cslammy/DLFO2/README.MD

Digital LFO using AVR328 MCU and embedded C.  Please see this blog post for more information:
http://audiodiwhy.blogspot.com/2021/10/dirty-digital-lfo-done.html
