cslammy/DLFO2/input output buffers DLFO.brd

## EAGLE design input output buffers DLFO.brd (2021-10-31)

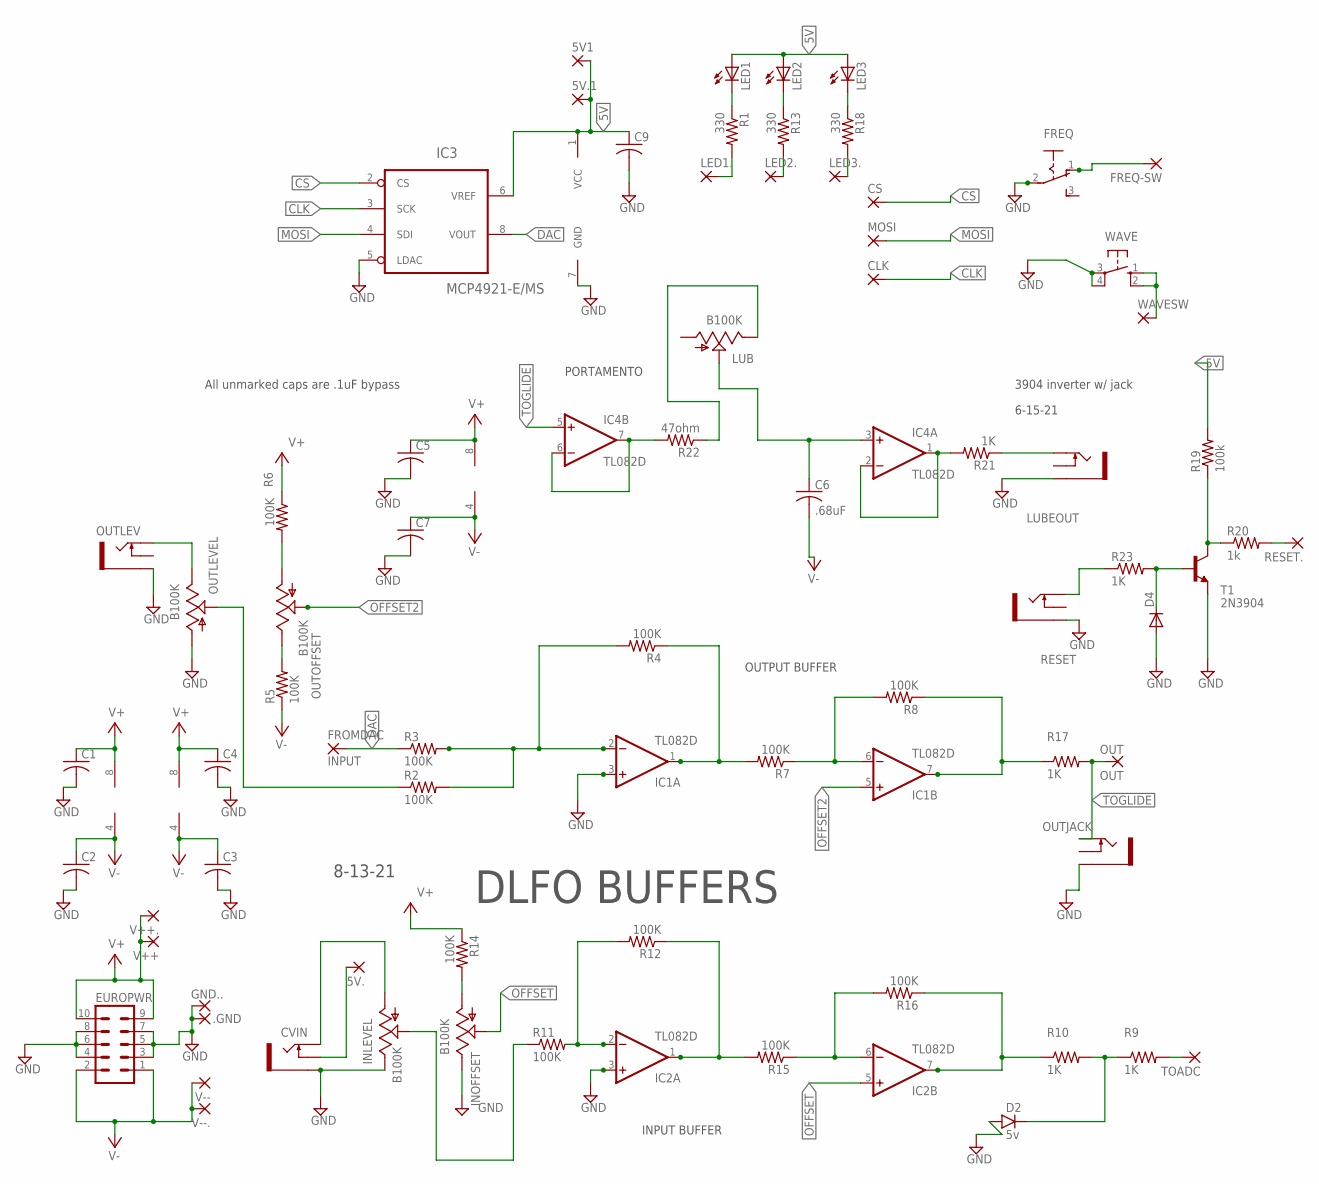
[picture p1: schematic input output buffers DLFO.sch]

Parts:
5V1, 5V.1: WIREPAD2,54/1,0; 2,54/1,0
5V., .GND: 3,17/1,3
C1, C2, C3, C4, C5, C7, C9: C-USC0603; C0603
C6: .68uF; C050-024X044
CLK: WIREPAD2,54/1,1; 2,54/1,1
CS: WIREPAD2,54/1,0; 2,54/1,0
CVIN: THONKICONNNEW; WQP-PJ301M-12_JACK
D2: 5v; DO41-2
D4: 1N4148DO35-10; DO35-10
EUROPWR: EURO_POWER_HEADERREGULAR; EURO_POWER_HEADER
FREQ: M251
FREQ-SW: WIREPAD2,54/0,9; 2,54/0,9
FROMDAC: INPUT; 3,17/1,3
GND..: 3,17/1,3
IC1, IC2, IC4: TL082D; SO08
IC3: MCP4921-E/MS; MSOP-8
INLEVEL: B100K; 9MM_SNAP-IN_POT
INOFFSET: B100K; 9MM_SNAP-IN_POT
LED1, LED2, LED3: LED3MM
LED1., LED2.: WIREPAD2,54/1,0; 2,54/1,0
LED3.: WIREPAD2,54/1,1; 2,54/1,1
LUB: B100K; 9MM_SNAP-IN_POT
LUBEOUT: THONKICONNNEW; WQP-PJ301M-12_JACK
MOSI: WIREPAD2,54/1,0; 2,54/1,0
OUT: OUT; 3,17/1,3
OUTJACK: THONKICONNNEW; WQP-PJ301M-12_JACK
OUTLEV: THONKICONNNEW; WQP-PJ301M-12_JACK
OUTLEVEL: B100K; 9MM_SNAP-IN_POT
OUTOFFSET: B100K; 9MM_SNAP-IN_POT
R1, R13, R18: 330; R0603
R2, R3, R4, R5, R6, R7, R8, R11, R12, R14, R15, R16: 100K; R0603
R9, R10, R17, R21, R23: 1K; R0603
R19: 100k; R0603
R20: 1k; R0603
R22: 47ohm; R0603
RESET: THONKICONNNEW; WQP-PJ301M-12_JACK
RESET.: 3,17/1,3
T1: 2N3904; TO92
TOADC: 3,17/1,3
V++, V++.: 3,17/1,3
V--, V--.: 3,17/1,3
WAVE: 10-XX; B3F-10XX
WAVESW: WIREPAD2,54/0,9; 2,54/0,9

Connections:
5V: 5V1.1, 5V.1.1, C9.1, IC3.1 (VCC), IC3.6 (VREF), LED1.A, LED2.A, LED3.A, R19.2
CLK: CLK.1, IC3.3 (SCK)
CS: CS.1, IC3.2 (CS)
DAC: FROMDAC.1, IC3.8 (VOUT), R3.1
GND: .GND.1, C1.2, C2.2, C3.2, C4.2, C5.2, C7.2, C9.2, CVIN.P$3_SLEEVE (SLEEVE), D2.A, D4.A, EUROPWR.3, EUROPWR.4, EUROPWR.5, EUROPWR.6, EUROPWR.7, EUROPWR.8, FREQ.2, GND...1, IC1.3 (+IN), IC2.3 (+IN), IC3.5 (LDAC), IC3.7 (GND), INLEVEL.3 (E), INOFFSET.3 (E), LUBEOUT.P$3_SLEEVE (SLEEVE), OUTJACK.P$3_SLEEVE (SLEEVE), OUTLEV.P$3_SLEEVE (SLEEVE), OUTLEVEL.1 (A), RESET.P$3_SLEEVE (SLEEVE), T1.3 (E), WAVE.3, WAVE.4 (P1)
LED1: LED1..1, R1.2
LED2: LED2..1, R13.2
MOSI: IC3.4 (SDI), MOSI.1
unnamed: OUTLEV.P$1_TIP (TIP), OUTLEVEL.3 (E)
unnamed: IC1.6 (-IN), R7.1, R8.2
unnamed: IC1.1 (OUT), R4.1, R7.2
unnamed: INOFFSET.1 (A), R14.2
unnamed: D2.C, R9.1, R10.2
unnamed: IC2.2 (-IN), R11.2, R12.2
unnamed: OUTLEVEL.2 (S), R2.1
unnamed: OUTOFFSET.1 (A), R6.2
unnamed: OUTOFFSET.3 (E), R5.2
unnamed: IC2.1 (OUT), R12.1, R15.2
unnamed: IC1.7 (OUT), R8.1, R17.1
unnamed: R23.1, RESET.P$1_TIP (TIP)
unnamed: CVIN.P$1_TIP (TIP), INLEVEL.1 (A)
unnamed: D4.C, R23.2, T1.2 (B)
unnamed: IC2.6 (-IN), R15.1, R16.2
unnamed: IC2.7 (OUT), R10.1, R16.1
unnamed: IC1.2 (-IN), R2.2, R3.2, R4.2
unnamed: LED3..1, R18.2
unnamed: R9.2, TOADC.1
unnamed: INLEVEL.2 (S), R11.1
unnamed: LED1.K (C), R1.1
unnamed: WAVE.1 (S), WAVE.2 (S1), WAVESW.1
unnamed: LED2.K (C), R13.1
unnamed: FREQ.1 (O), FREQ-SW.1
unnamed: LED3.K (C), R18.1
unnamed: R19.1, R20.1, T1.1 (C)
unnamed: 5V..1, CVIN.P$2_SWITCH (SWITCH)
unnamed: IC4.6 (-IN), IC4.7 (OUT), R22.2
unnamed: IC4.1 (OUT), IC4.2 (-IN), R21.2
unnamed: LUBEOUT.P$1_TIP (TIP), R21.1
unnamed: LUB.3 (E), R22.1
unnamed: C6.1, IC4.3 (+IN), LUB.2 (S)
unnamed: R20.2, RESET..1
OFFSET: IC2.5 (+IN), INOFFSET.2 (S)
OFFSET2: IC1.5 (+IN), OUTOFFSET.2 (S)
TOGLIDE: IC4.5 (+IN), OUT.1, OUTJACK.P$1_TIP (TIP), R17.2
V+: C1.1, C4.1, C5.1, EUROPWR.9, EUROPWR.10, IC1.8 (V+), IC2.8 (V+), IC4.8 (V+), R6.1, R14.1, V++.1, V++..1
V-: C2.1, C3.1, C6.2, C7.1, EUROPWR.1, EUROPWR.2, IC1.4 (V-), IC2.4 (V-), IC4.4 (V-), R5.1, V--.1, V--..1

Notes on the sheet:
OUTPUT BUFFER
INPUT BUFFER
DLFO BUFFERS
8-13-21
PORTAMENTO
3904 inverter w/ jack
6-15-21
All unmarked caps are .1uF bypass

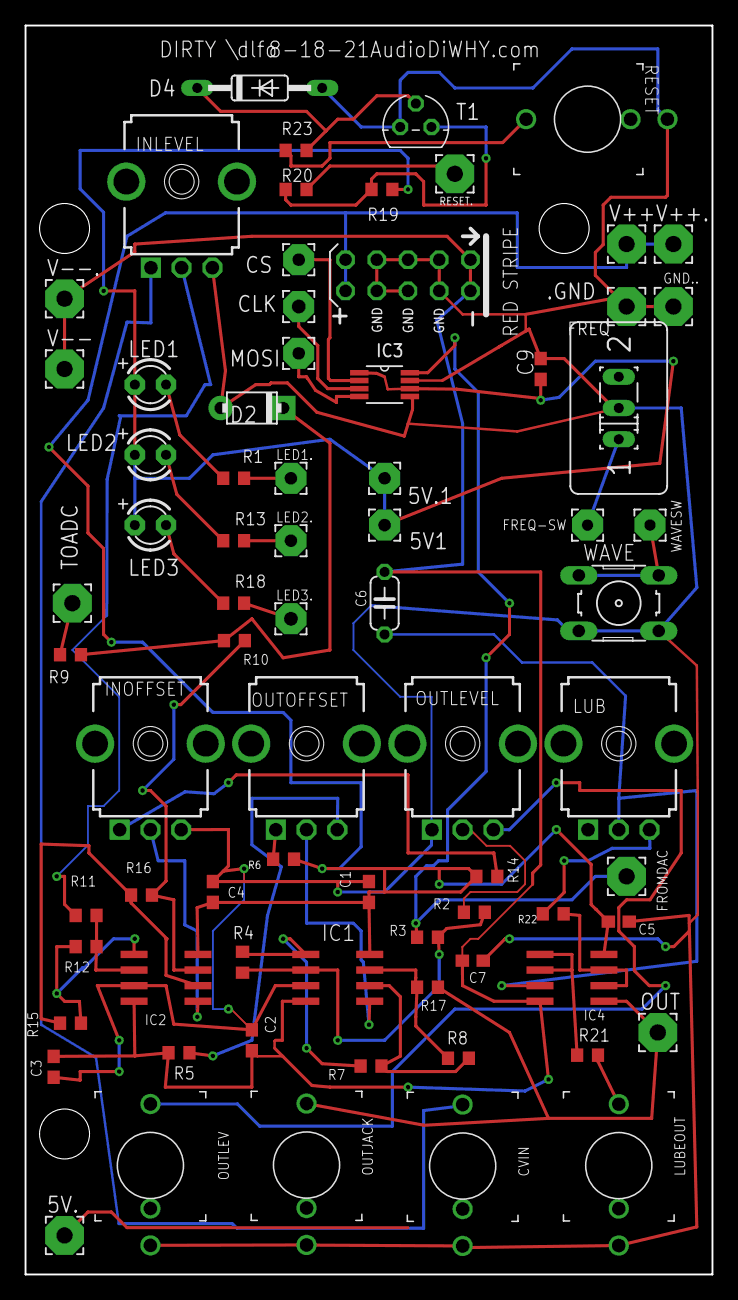
[picture p2: board input output buffers DLFO.brd from above]

Board: 2 copper layers, 55.9 x 101.6 mm, 75 parts (0 on the bottom side), 46 nets.
