cslammy/DLFO2/DLFO2 wiring schem brd.pdf

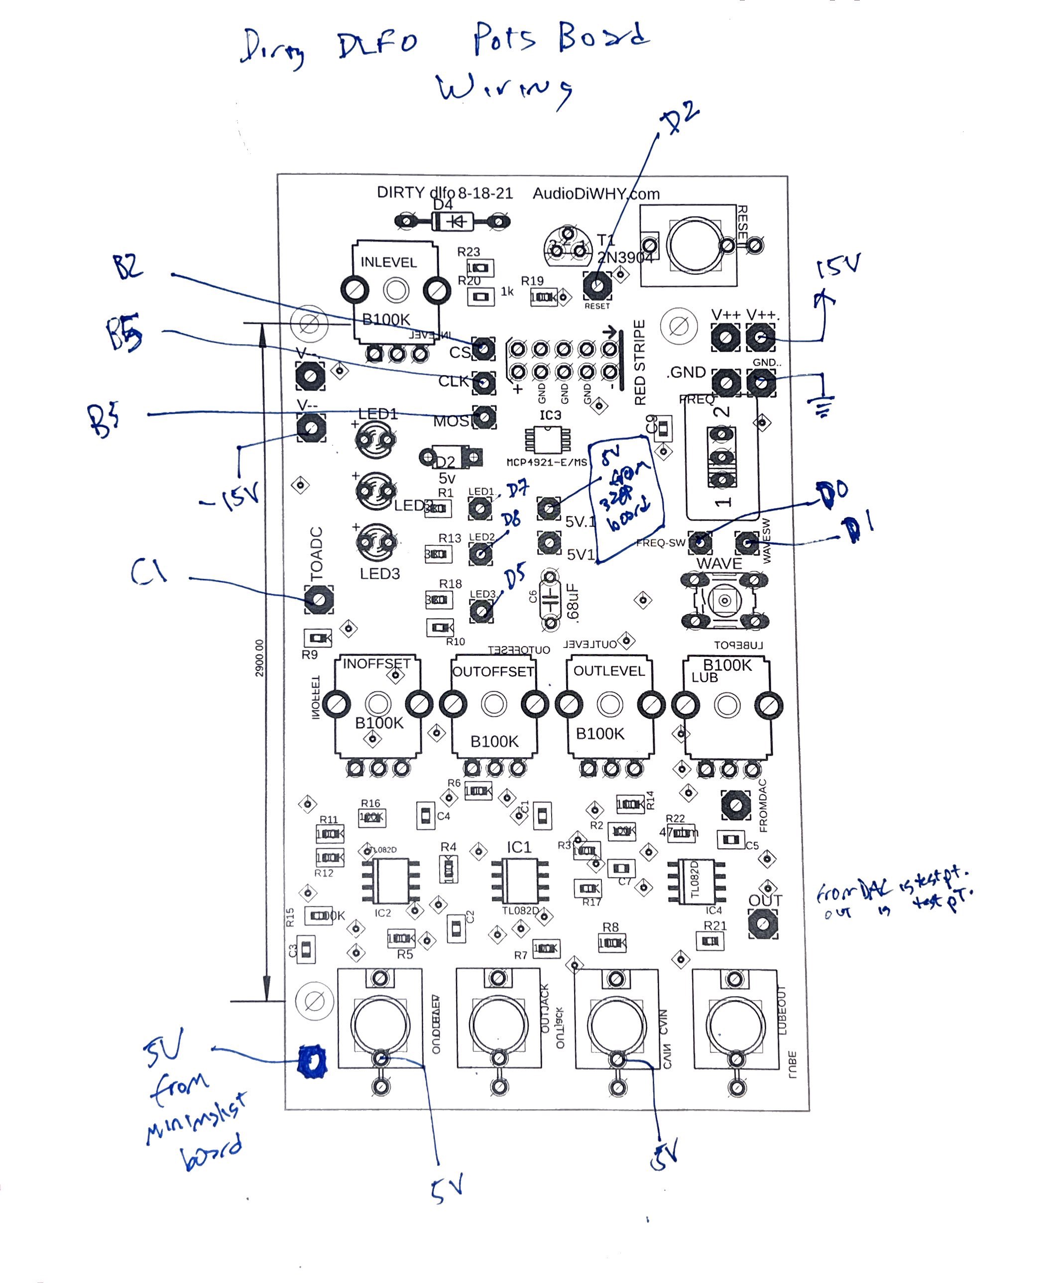
[picture p3: page 1]
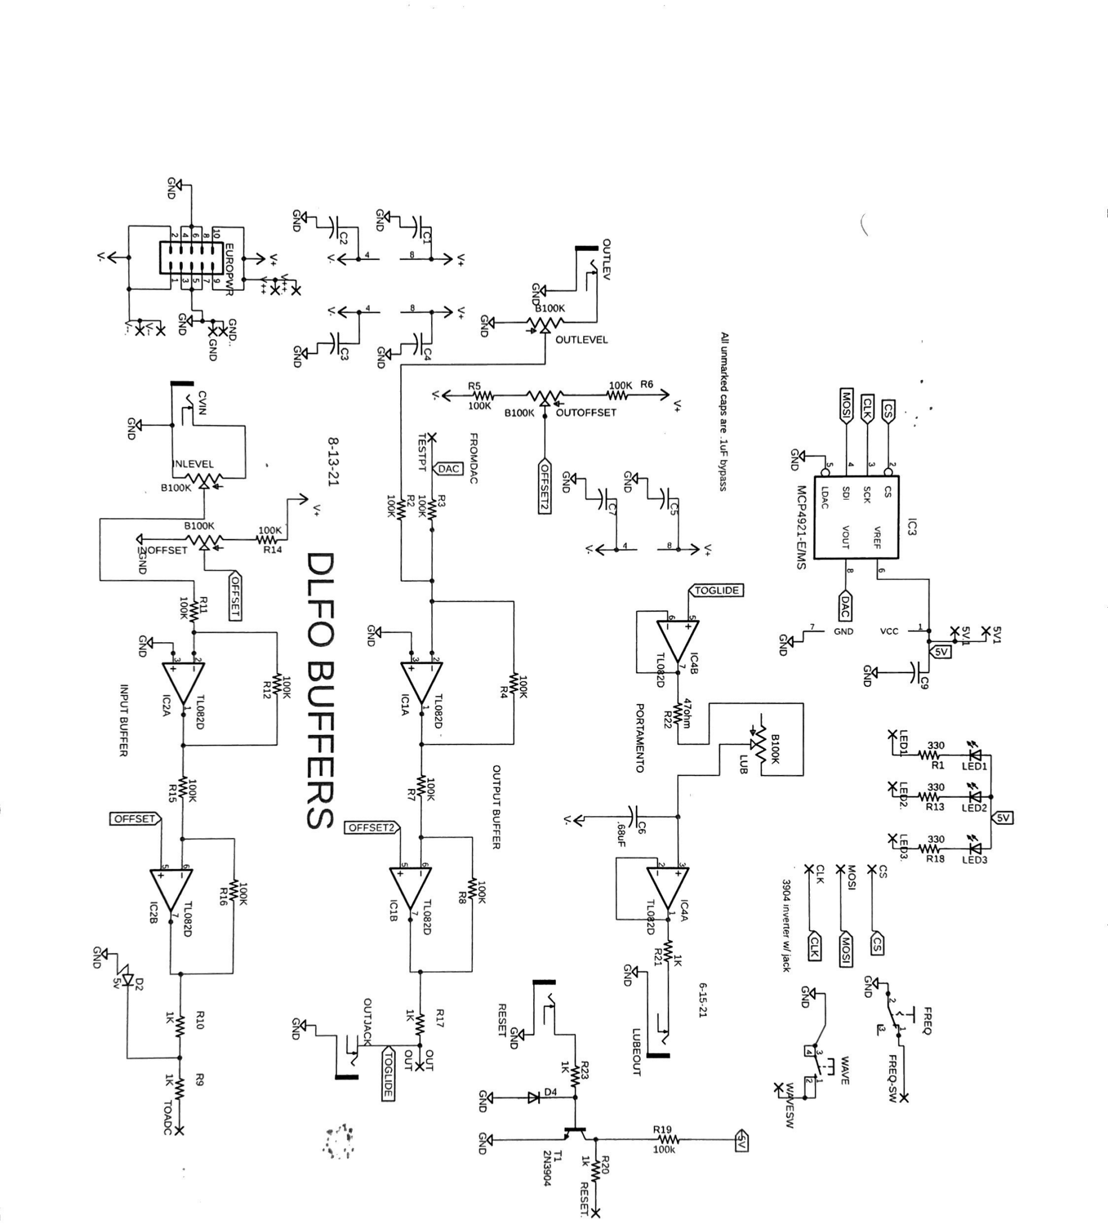
[picture p4: page 2]

Leos

z
FREQ

eb3. T

FREQ-SW

recs

wsx] &%

soi vouT[-® sos __ Kost] WAVE

LoaAc i

cLK Xo KEK]

>

? MCP4921-E/MS p

100K R6

OUTOFFSET

OUTLEVEL

TLO82D

INPUT BUFFER

## DIRTY difo8-18-21 AudioDIWHY.com

# D4GES

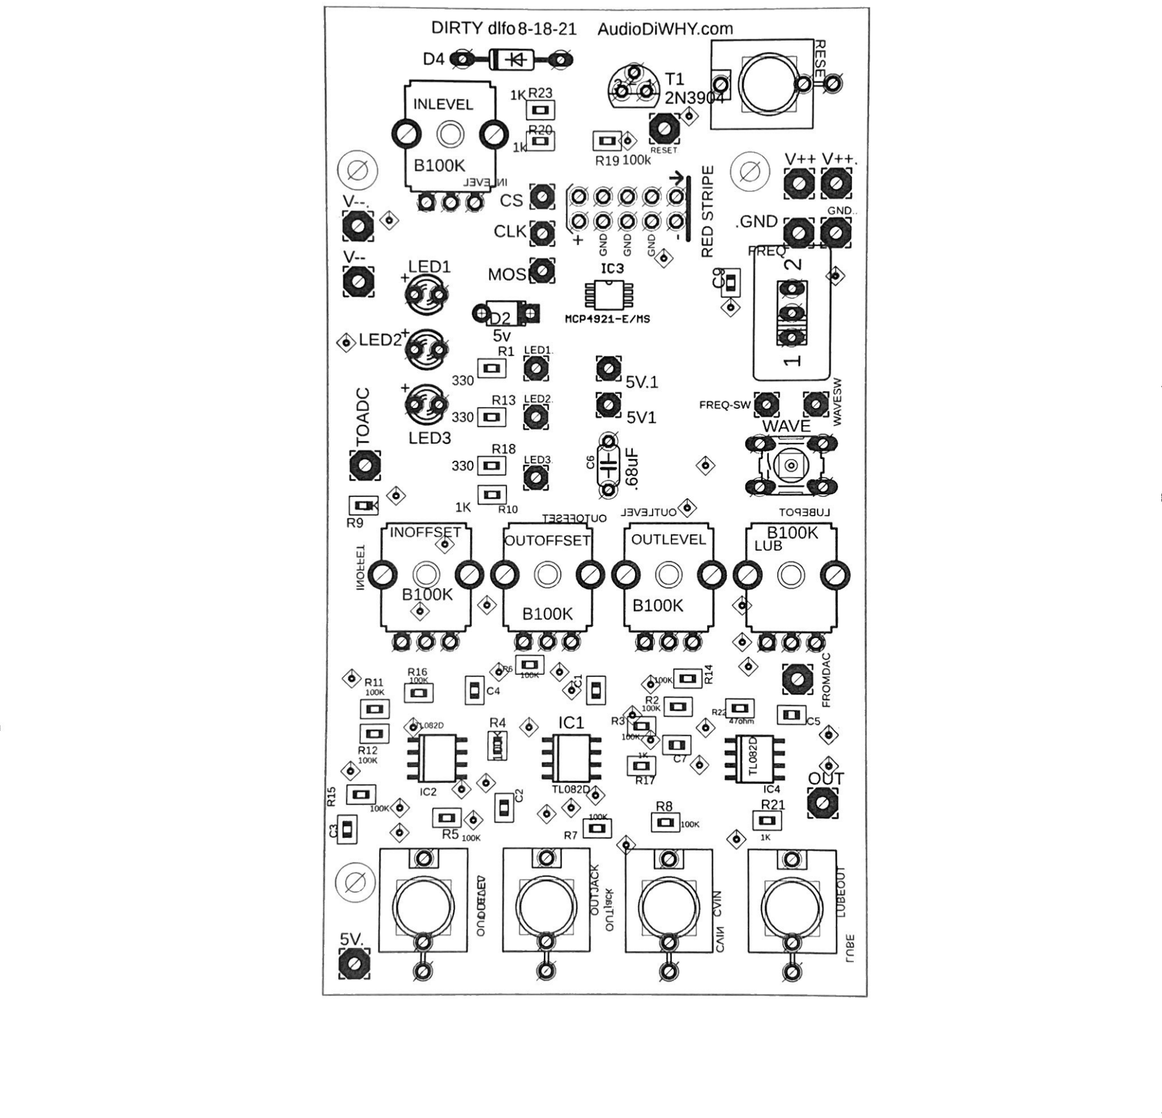
[picture p5: page 3]

R13 Leo. | FREQ-SW
af] @

TOWUIaUI

## 1BLOOK

o>

@
